HeronMkII/pay-pcbs/README.md

# Payload Subsystem PCBs

Currently includes:  

* pay-ssm v2
* pay-led v1
* pay-sensor v1

Schematic & PCB layout files for each respective board.

Layout done in KiCad.
