HeronMkII/pay-pcbs/pay-led/_outputs/pay-led-pcb.pdf

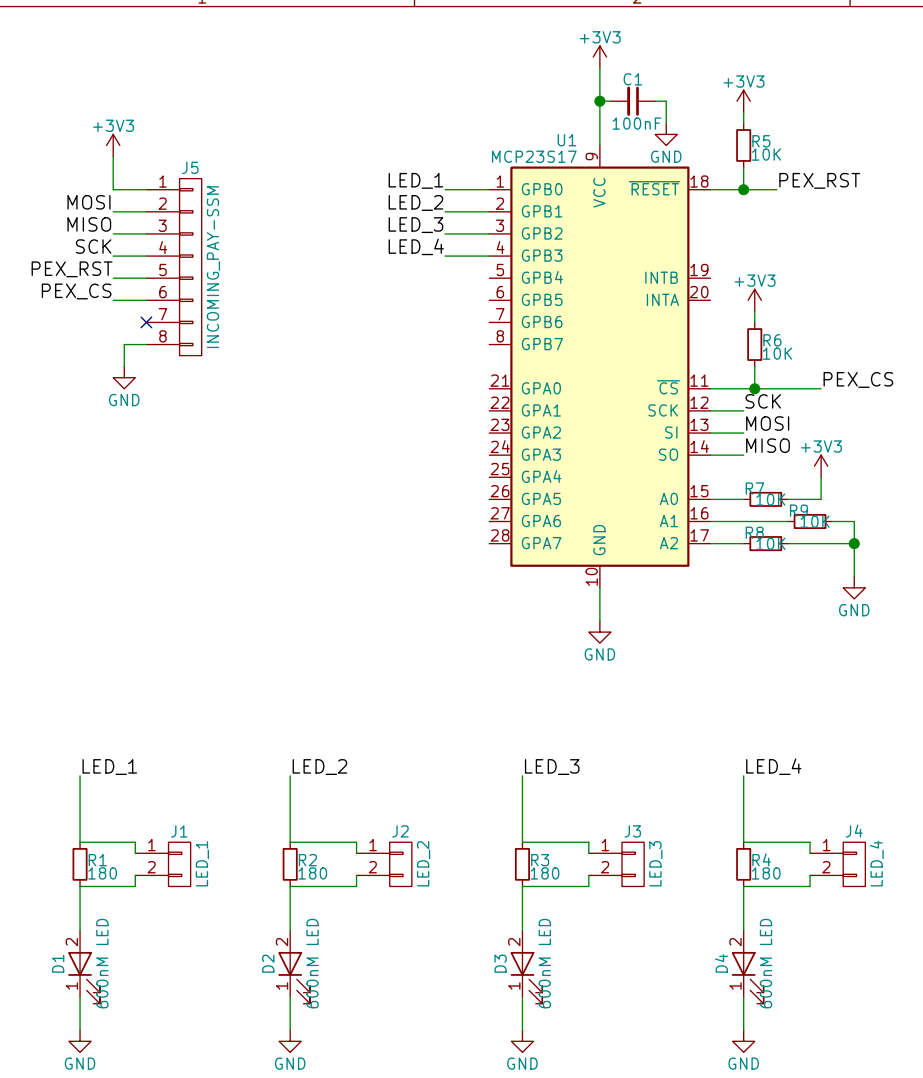
[picture p1: page 1]

File: pay-led-pcb.sch Sheet: /
