HeronMkII/pay-pcbs/pay-sensor/_outputs/pay_sensors.pdf

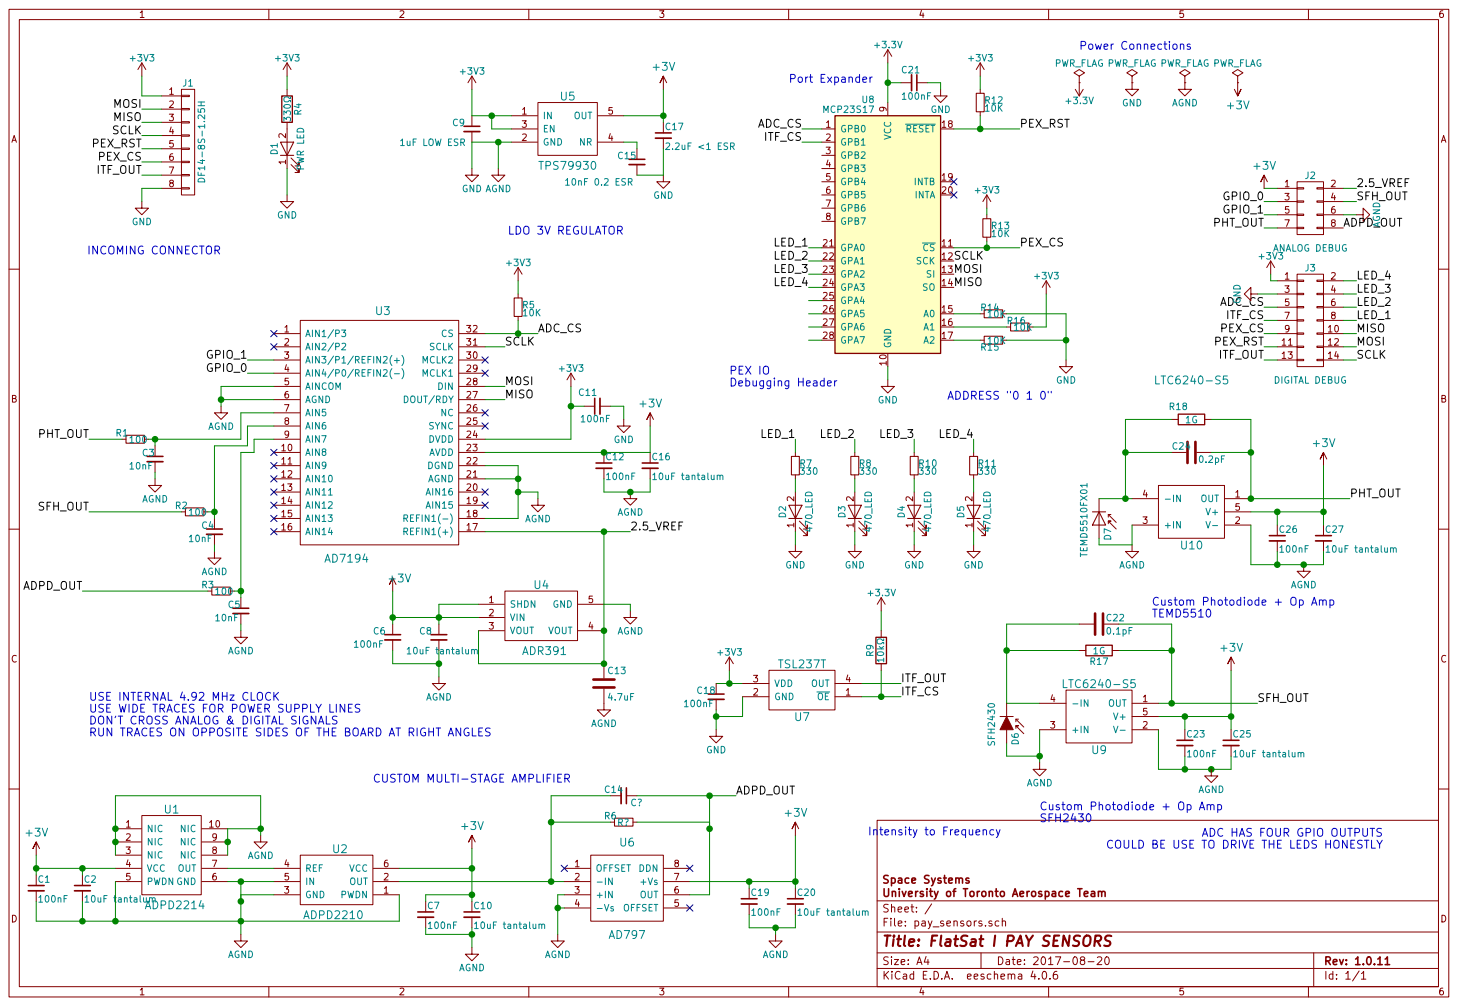
[picture p2: page 1]

11 | 12
13 | 14

USE INTERNAL 4.92 MHz CLOCK
USE WIDE TRACES FOR POWER SUPPLY LINES
DON'T CROSS ANALOG & DIGITAL SIGNALS
RUN TRACES ON OPPOSITE SIDES OF THE BOARD AT RIGHT ANGLES

CUSTOM MULTI-STAGE AMPLIFIER

Custom Photodiode + Op Amp
SFH2430

ADC HAS FOUR GPIO OUTPUTS

COULD BE USE TO DRIVE THE LEDS HONESTLY

Id: 1/1 Title: FlatSat I PAY SENSORS
