HeronMkII/pay-pcbs/pay-ssm/_outputs/pay_ssm.pdf

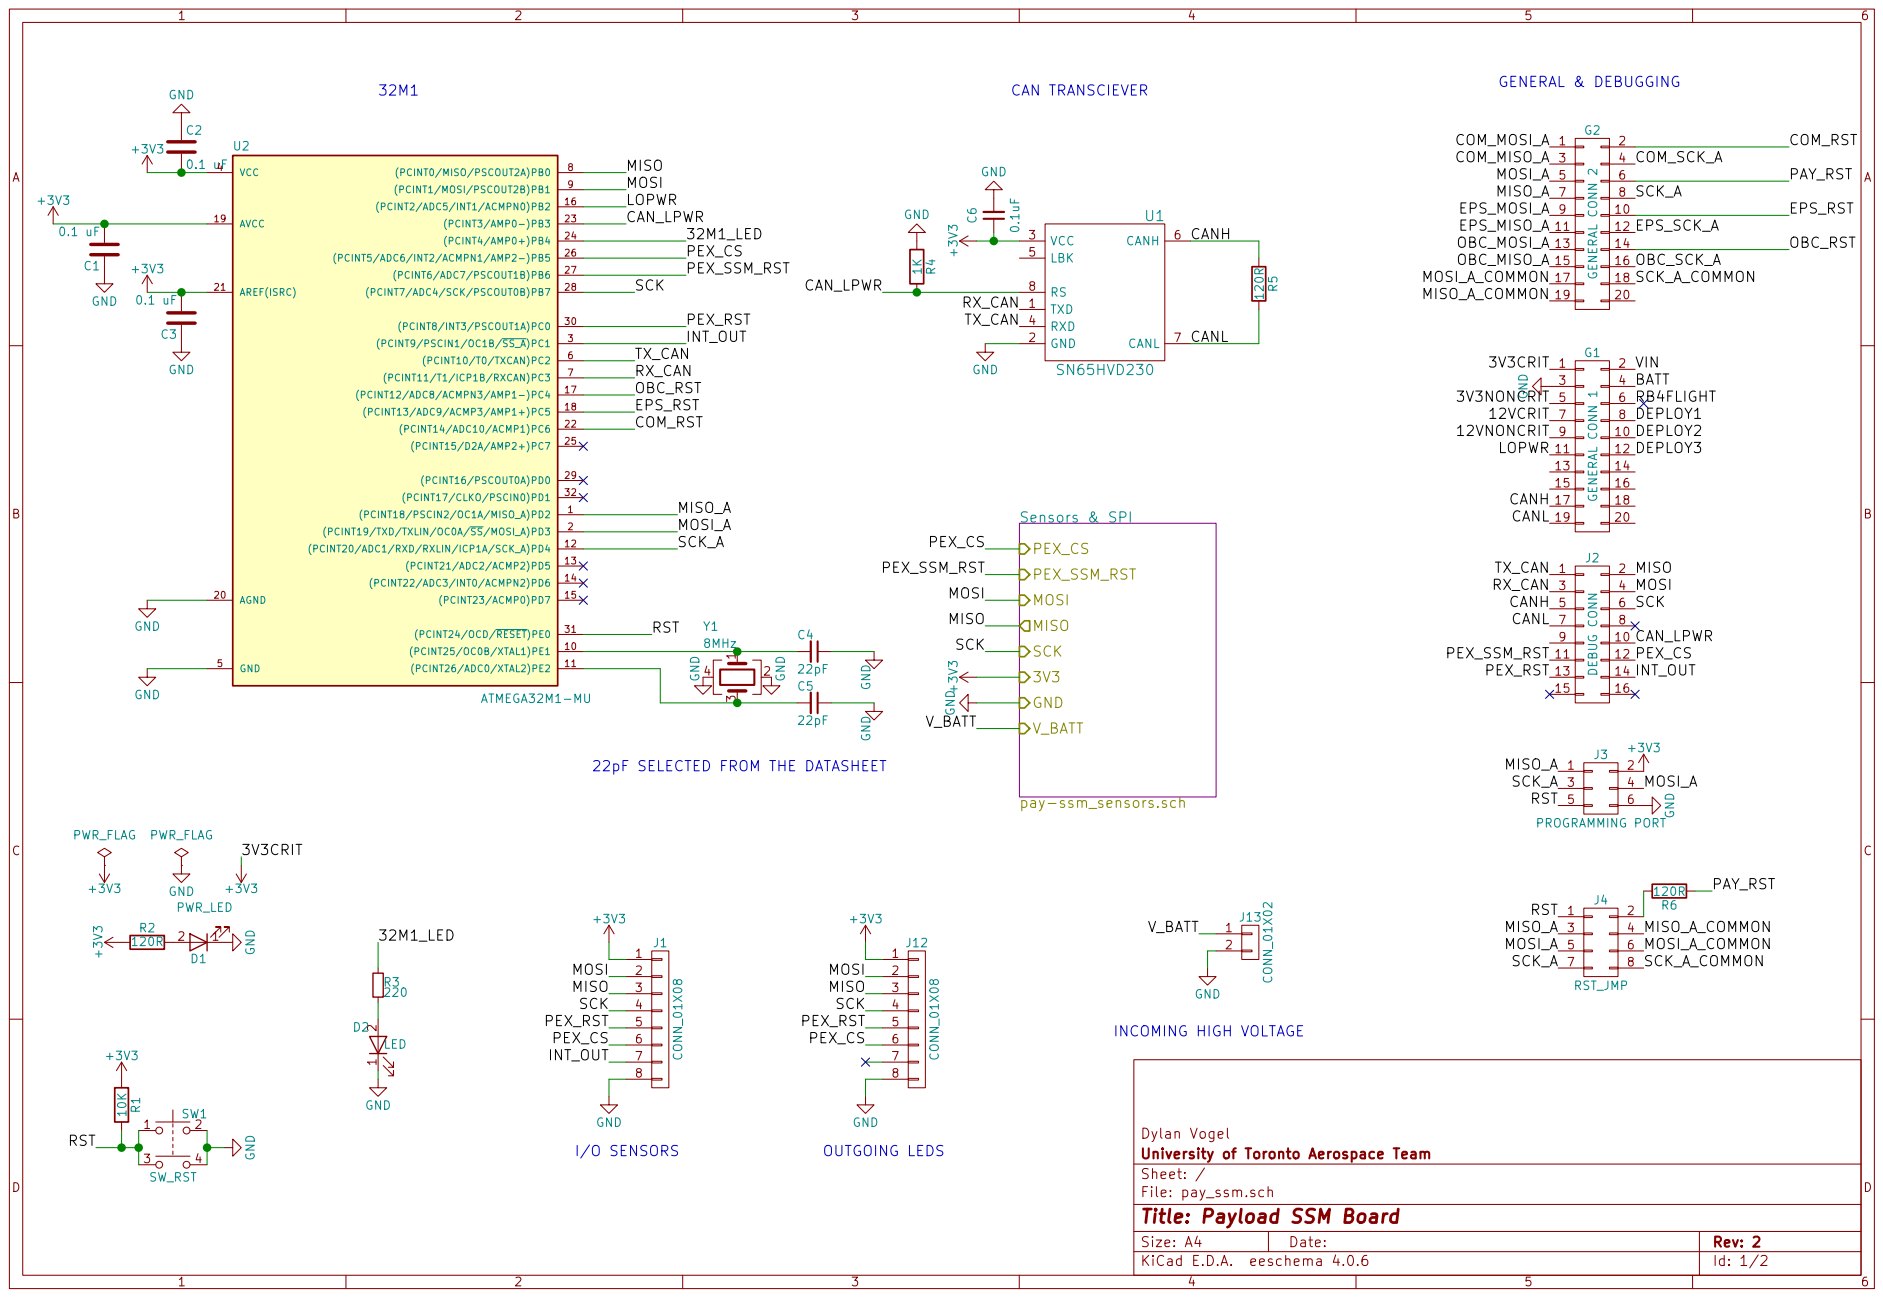
[picture p3: page 1]

9 | 10

11 | 12
13 | 14

22pF SELECTED FROM THE DATASHEET

File: pay_ssm.sch Sheet: / University of Toronto Aerospace Team

Id: 1/2 Title: Payload SSM Board

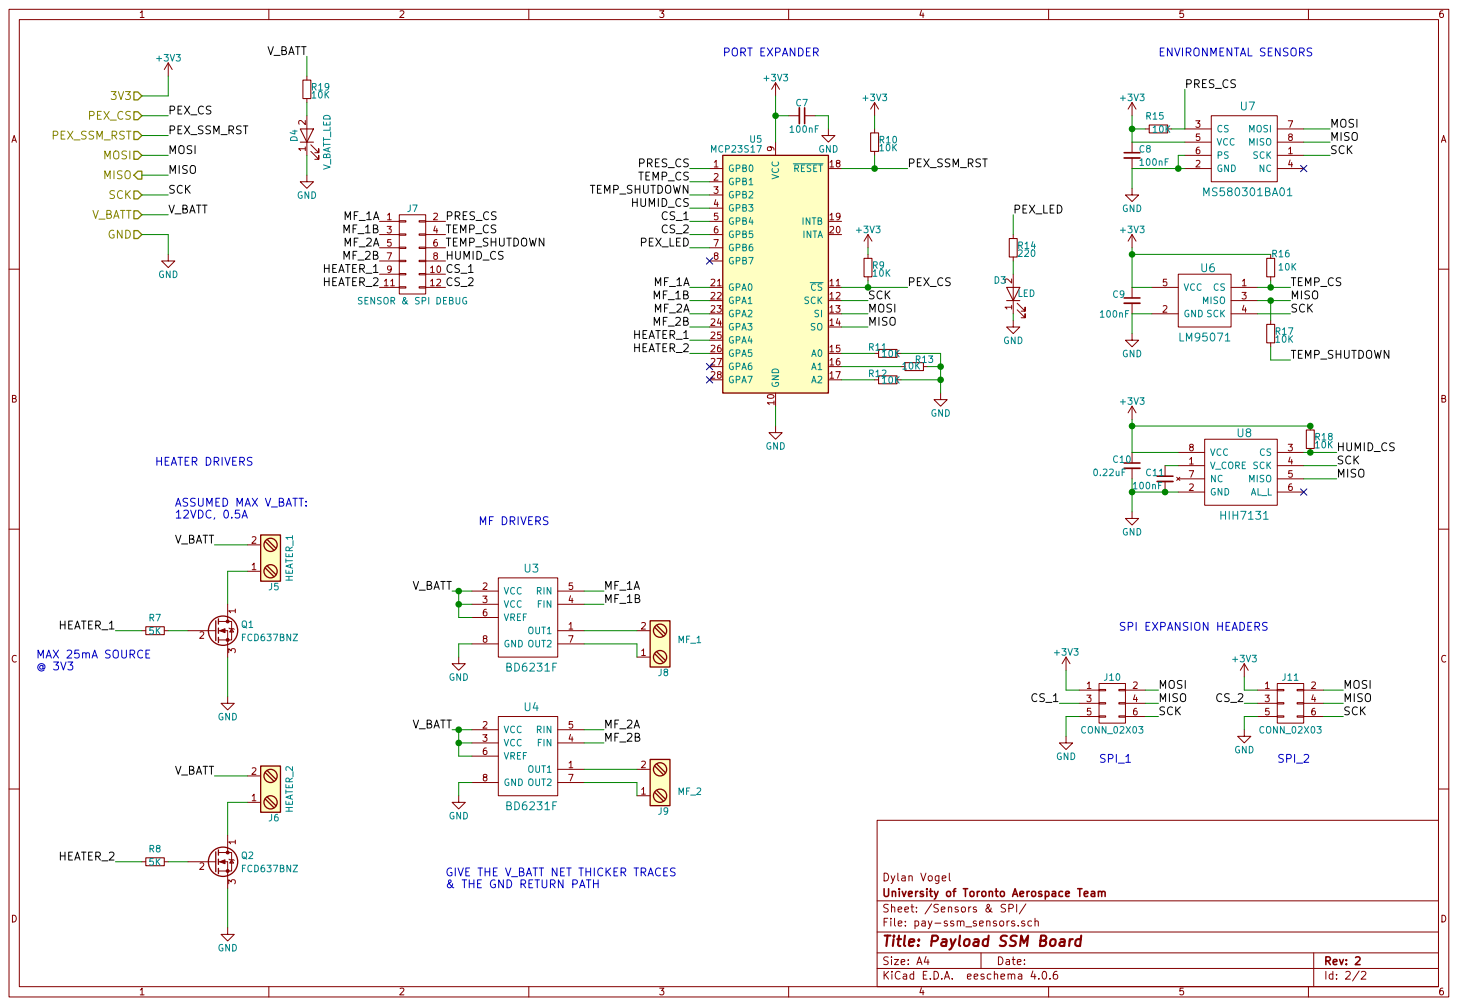
[picture p4: page 2]

Dylan Vogel
File: pay-ssm_sensors.sch Sheet: /Sensors & SPI/ University of Toronto Aerospace Team

& THE GND RETURN PATH

Id: 2/2 Title: Payload SSM Board
