HeronMkII/pay-pcbs/pay-sensor/pay_sensors.kicad_pcb

## KiCad design pay-sensor/pay_sensors.kicad_pcb (2017-09-02)

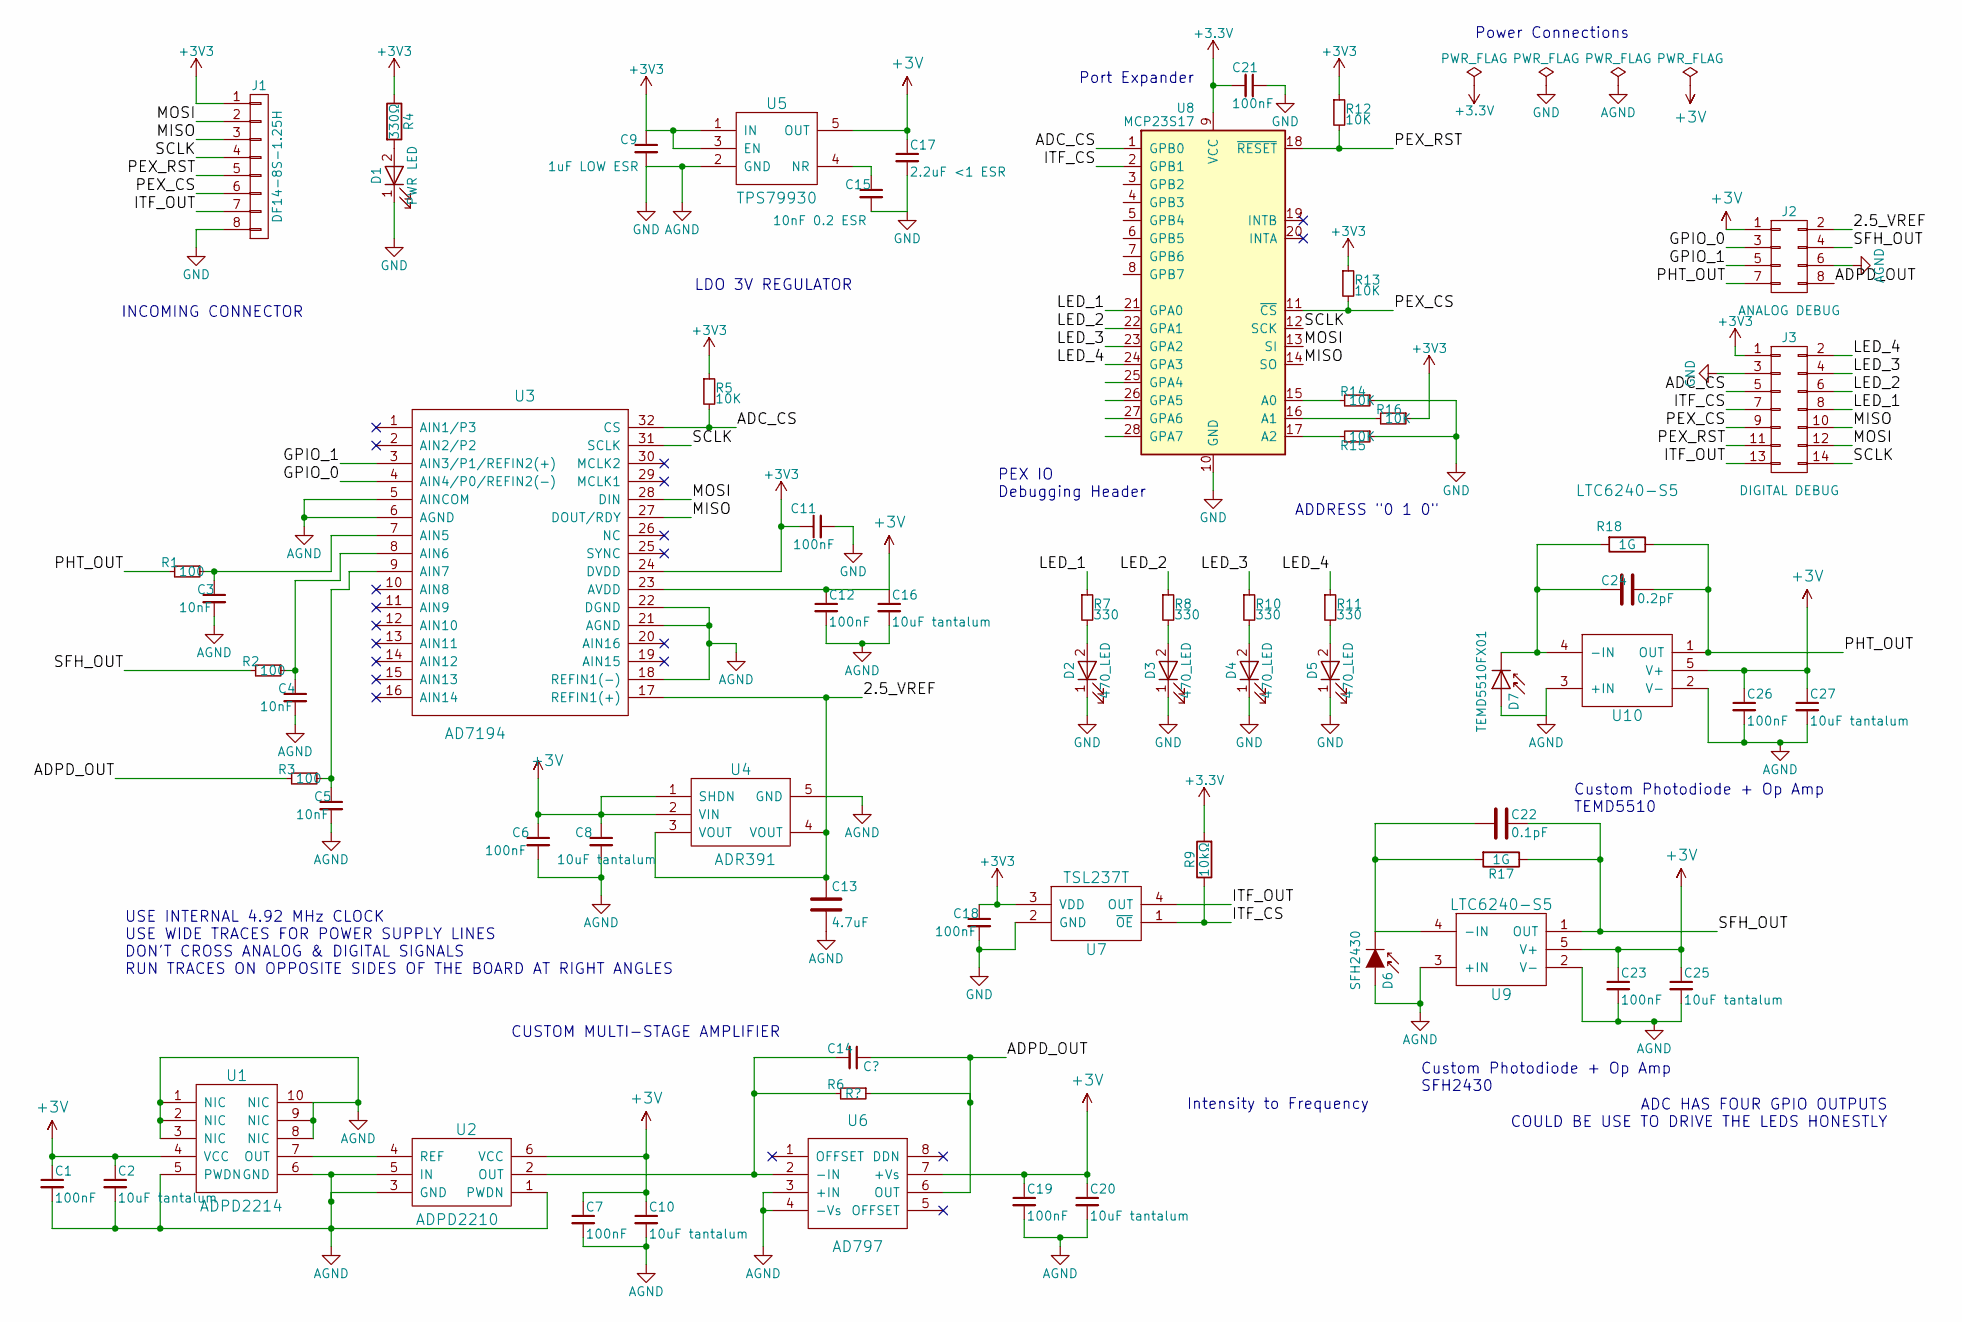
[picture p5: schematic pay_sensors.sch, FlatSat I PAY SENSORS]

Parts:
C1, C6, C7, C11, C12, C18, C19, C21, C23, C26: 100nF; C_0603
C2, C8, C10, C16, C20, C25, C27: 10uF tantalum; C_0603
C3, C4, C5: 10nF; C_0603
C9: 1uF LOW ESR; C_0603
C13: 4.7uF; C_0603
C14: C?; C_0603
C15: 10nF 0.2 ESR; C_0603
C17: 2.2uF <1 ESR; C_0603
C22: 0.1pF; C_0603
C24: 0.2pF; C_0603
D1: PWR LED; LED_0603
D2, D3, D4, D5: 470_LED; LED_0603
D6: SFH2430
D7: TEMD5510FX01; TEMD5510
J1: DF14-8S-1.25H; Hirose_DF14-8P-1.25H
J2: ANALOG DEBUG; Socket_Strip_Straight_2x04_Pitch2.54mm
J3: DIGITAL DEBUG; Socket_Strip_Straight_2x07_Pitch2.54mm
R1, R2, R3: 100; R_0603
R4: 330Ω; R_0603
R5, R12, R13, R14, R15, R16: 10K; R_0603
R6: R?; R_0603
R7, R8, R10, R11: 330; R_0603
R9: 10kΩ; R_0603
R17, R18: 1G; R_0603
U1: ADPD2214
U2: ADPD2210
U3: AD7194; QFN-32-1EP_5x5mm_Pitch0.5mm
U4: ADR391; SOT-23-5
U5: TPS79930; SOT-23-5
U6: AD797; SOIC-8_3.9x4.9mm_Pitch1.27mm
U7: TSL237T
U8: MCP23S17; SSOP-28_5.3x10.2mm_Pitch0.65mm
U9, U10: LTC6240-S5; SOT-23-5

Connections:
+3V: C1.1, C2.1, C6.1, C7.1, C8.1, C10.1, C12.1, C16.1, C17.1, C19.1, C20.1, C23.1, C25.1, C26.1, C27.1, J2.1, U1.4 (VCC), U2.6 (VCC), U3.23 (AVDD), U4.1 (SHDN), U4.2 (VIN), U5.5 (OUT), U6.7 (+Vs), U9.5 (V+), U10.5 (V+)
/2.5_VREF: C13.1, J2.2, U3.17 (REFIN1(+)), U4.3 (VOUT), U4.4 (VOUT)
/ADC_CS: J3.5, R5.2, U3.32 (CS), U8.1 (GPB0)
/ADPD_OUT: C14.1, J2.8, R3.2, R6.1, U6.6 (OUT)
/GPIO_0: J2.3, U3.4 (AIN4/P0/REFIN2(-))
/GPIO_1: J2.5, U3.3 (AIN3/P1/REFIN2(+))
/ITF_CS: J3.7, R9.1, U7.1 (~OE), U8.2 (GPB1)
/ITF_OUT: J1.7, J3.13, U7.4 (OUT)
/LED_1: J3.8, R7.1, U8.21 (GPA0)
/LED_2: J3.6, R8.1, U8.22 (GPA1)
/LED_3: J3.4, R10.1, U8.23 (GPA2)
/LED_4: J3.2, R11.1, U8.24 (GPA3)
/MISO: J1.3, J3.10, U3.27 (DOUT/RDY), U8.14 (SO)
/MOSI: J1.2, J3.12, U3.28 (DIN), U8.13 (SI)
/PEX_CS: J1.6, J3.9, R13.2, U8.11 (~CS)
/PEX_RST: J1.5, J3.11, R12.2, U8.18 (~RESET)
/PHT_OUT: C24.1, J2.7, R1.2, R18.1, U10.1 (OUT)
/SCLK: J1.4, J3.14, U3.31 (SCLK), U8.12 (SCK)
/SFH_OUT: C22.1, J2.4, R2.2, R17.1, U9.1 (OUT)
AGND: C1.2, C2.2, C3.2, C4.2, C5.2, C6.2, C7.2, C8.2, C9.2, C10.2, C11.2, C12.2, C13.2, C15.2, C16.2, C17.2, C18.2, C19.2, C20.2, C21.1, C23.2, C25.2, C26.2, C27.2, D1.1 (K), D2.1 (K), D3.1 (K), D4.1 (K), D5.1 (K), D6.2 (A), D7.2 (A), J1.8, J2.6, J3.3, R14.1, R15.1, U1.1 (NIC), U1.2 (NIC), U1.3 (NIC), U1.5 (PWDN), U1.6 (GND), U1.8 (NIC), U1.9 (NIC), U1.10 (NIC), U2.1 (PWDN), U2.3 (GND), U2.5 (IN), U3.5 (AINCOM), U3.6 (AGND), U3.18 (REFIN1(-)), U3.21 (AGND), U3.22 (DGND), U4.5 (GND), U5.2 (GND), U6.3 (+IN), U6.4 (-Vs), U7.2 (GND), U8.10 (GND), U9.2 (V-), U9.3 (+IN), U10.2 (V-), U10.3 (+IN)
unnamed: C3.1, R1.1, U3.7 (AIN5)
unnamed: C4.1, R2.1, U3.8 (AIN6)
unnamed: C5.1, R3.1, U3.9 (AIN7)
unnamed: C14.2, R6.2, U2.2 (OUT), U6.2 (-IN)
unnamed: C15.1, U5.4 (NR)
unnamed: C22.2, D6.1 (K), R17.2, U9.4 (-IN)
unnamed: C24.2, D7.1 (K), R18.2, U10.4 (-IN)
unnamed: D1.2 (A), R4.2
unnamed: D2.2 (A), R7.2
unnamed: D3.2 (A), R8.2
unnamed: D4.2 (A), R10.2
unnamed: D5.2 (A), R11.2
unnamed: R14.2, U8.15 (A0)
unnamed: R15.2, U8.17 (A2)
unnamed: R16.2, U8.16 (A1)
unnamed: U1.7 (OUT), U2.4 (REF)

Notes on the sheet:
Port Expander
Power Connections
Custom Photodiode + Op Amp TEMD5510
PEX IO Debugging Header
ADDRESS "0 1 0"
INCOMING CONNECTOR
LDO 3V REGULATOR
USE INTERNAL 4.92 MHz CLOCK USE WIDE TRACES FOR POWER SUPPLY LINES DON'T CROSS ANALOG & DIGITAL SIGNALS RUN TRACES ON OPPOSITE SIDES OF THE BOARD AT RIGHT ANGLES
CUSTOM MULTI-STAGE AMPLIFIER
ADC HAS FOUR GPIO OUTPUTS COULD BE USE TO DRIVE THE LEDS HONESTLY
Custom Photodiode + Op Amp SFH2430
Intensity to Frequency

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
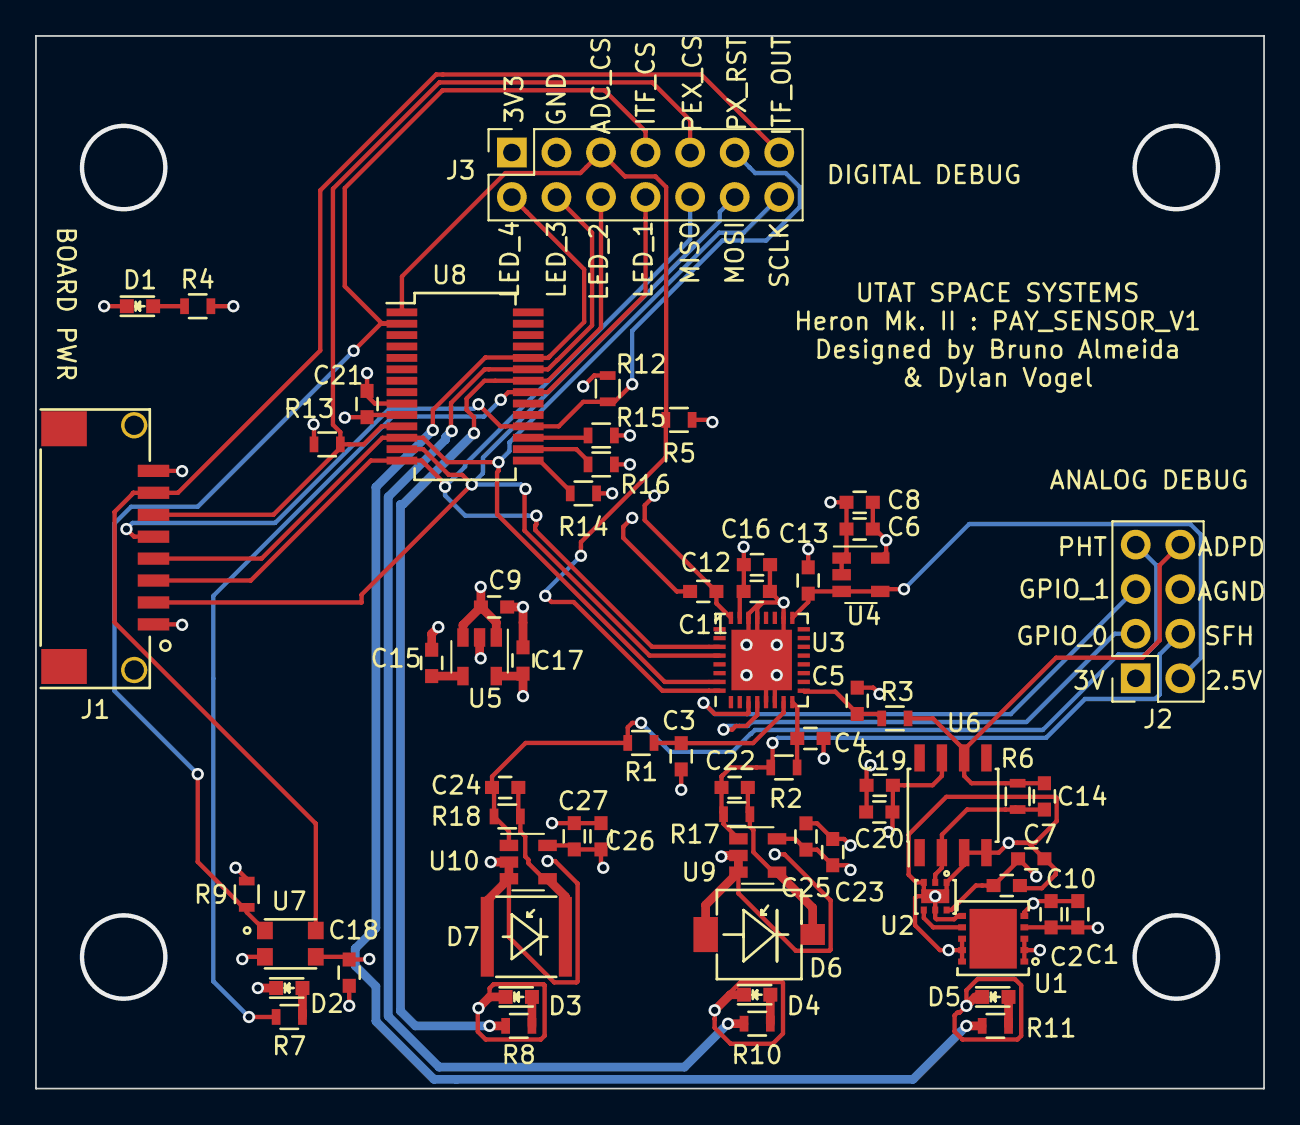
[picture p6: board pay_sensors.kicad_pcb from above]

Board: 4 copper layers, 70.0 x 60.0 mm, 65 parts (0 on the bottom side), 37 nets.
