HeronMkII/pay-pcbs/pay-ssm/pay_ssm.kicad_pcb

## KiCad design pay-ssm/pay_ssm.kicad_pcb (2017-09-02)

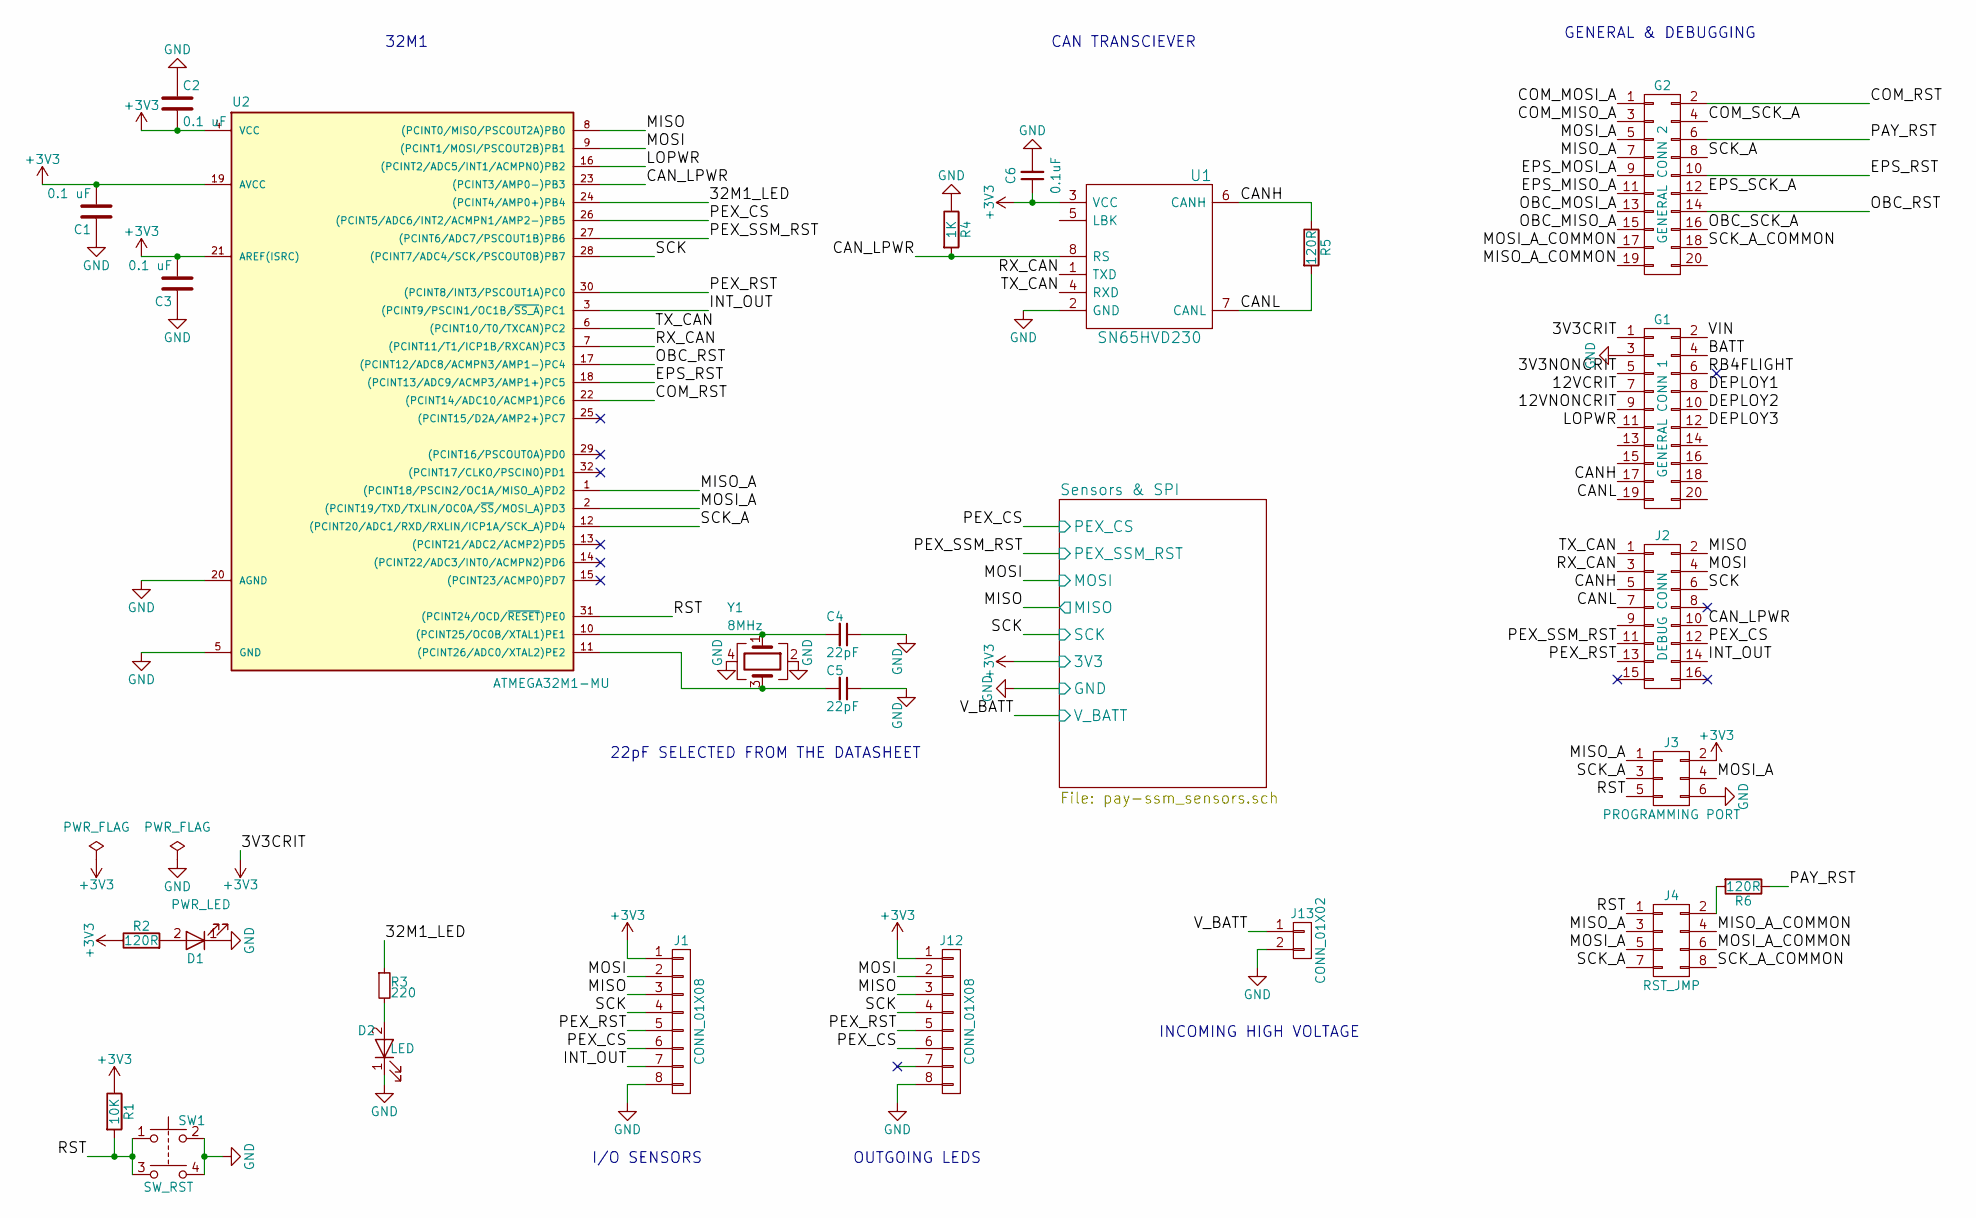
[picture p7: schematic pay_ssm.sch, Payload SSM Board]

Parts:
C1, C2, C3: 0.1 uF; C_0603
C4, C5: 22pF; C_0603
C6: 0.1uF; C_0603
D1: PWR_LED; LED_0603
D2: LED; LED_0603
G1: GENERAL CONN 1; Socket_Strip_Straight_2x10_Pitch2.54mm
G2: GENERAL CONN 2; Socket_Strip_Straight_2x10_Pitch2.54mm
J1, J12: CONN_01X08; Hirose_DF14-8P-1.25H
J2: DEBUG CONN; Socket_Strip_Straight_2x08_Pitch2.54mm
J3: PROGRAMMING PORT; IDC_Header_Straight_6pins
J4: RST_JMP; Socket_Strip_Straight_2x04_Pitch2.54mm
J13: CONN_01X02; Socket_Strip_Straight_1x02_Pitch2.54mm
R1: 10K; R_0603
R2, R5, R6: 120R; R_0603
R3: 220; R_0603
R4: 1K; R_0603
SW1: SW_RST; SW_SPST_B3S-1000
U1: SN65HVD230; SOIC-8_3.9x4.9mm_Pitch1.27mm
U2: ATMEGA32M1-MU; TQFP-32_7x7mm_Pitch0.8mm
Y1: 8MHz; Crystal_SMD_Abracon_ABM3B-4pin_5.0x3.2mm

Connections:
+3V3: C1.2, C2.2, C3.2, C6.1, G1.1, J1.1, J3.2, J12.1, R1.1, R2.1, U1.3 (VCC), U2.4 (VCC), U2.19 (AVCC), U2.21 (AREF(ISRC)); also elsewhere on the board
/3V3NONCRIT: G1.5
/12VCRIT: G1.7
/12VNONCRIT: G1.9
/32M1_LED: R3.1, U2.24 ((PCINT4/AMP0+)PB4)
/BATT: G1.4
/CANH: G1.17, J2.5, R5.1, U1.6 (CANH)
/CANL: G1.19, J2.7, R5.2, U1.7 (CANL)
/CAN_LPWR: J2.10, R4.2, U1.8 (RS), U2.23 ((PCINT3/AMP0-)PB3)
/COM_MISO_A: G2.3
/COM_MOSI_A: G2.1
/COM_RST: G2.2, U2.22 ((PCINT14/ADC10/ACMP1)PC6)
/COM_SCK_A: G2.4
/DEPLOY1: G1.8
/DEPLOY2: G1.10
/DEPLOY3: G1.12
/EPS_MISO_A: G2.11
/EPS_MOSI_A: G2.9
/EPS_RST: G2.10, U2.18 ((PCINT13/ADC9/ACMP3/AMP1+)PC5)
/EPS_SCK_A: G2.12
/INT_OUT: J1.7, J2.14, U2.3 ((PCINT9/PSCIN1/OC1B/~SS_A~)PC1)
/LOPWR: G1.11, U2.16 ((PCINT2/ADC5/INT1/ACMPN0)PB2)
/MISO: J1.3, J2.2, J12.3, U2.8 ((PCINT0/MISO/PSCOUT2A)PB0); also elsewhere on the board
/MISO_A: G2.7, J3.1, J4.3, U2.1 ((PCINT18/PSCIN2/OC1A/MISO_A)PD2)
/MISO_A_COMMON: G2.19, J4.4
/MOSI: J1.2, J2.4, J12.2, U2.9 ((PCINT1/MOSI/PSCOUT2B)PB1); also elsewhere on the board
/MOSI_A: G2.5, J3.4, J4.5, U2.2 ((PCINT19/TXD/TXLIN/OC0A/~SS~/MOSI_A)PD3)
/MOSI_A_COMMON: G2.17, J4.6
/OBC_MISO_A: G2.15
/OBC_MOSI_A: G2.13
/OBC_RST: G2.14, U2.17 ((PCINT12/ADC8/ACMPN3/AMP1-)PC4)
/OBC_SCK_A: G2.16
/PAY_RST: G2.6, R6.1
/PEX_CS: J1.6, J2.12, J12.6, U2.26 ((PCINT5/ADC6/INT2/ACMPN1/AMP2-)PB5); also elsewhere on the board
/PEX_RST: J1.5, J2.13, J12.5, U2.30 ((PCINT8/INT3/PSCOUT1A)PC0)
/PEX_SSM_RST: J2.11, U2.27 ((PCINT6/ADC7/PSCOUT1B)PB6); also elsewhere on the board
/RB4FLIGHT: G1.6
/RST: J3.5, J4.1, R1.2, SW1.1, SW1.3, U2.31 ((PCINT24/OCD/~RESET~)PE0)
/RX_CAN: J2.3, U1.1 (TXD), U2.7 ((PCINT11/T1/ICP1B/RXCAN)PC3)
/SCK: J1.4, J2.6, J12.4, U2.28 ((PCINT7/ADC4/SCK/PSCOUT0B)PB7); also elsewhere on the board
/SCK_A: G2.8, J3.3, J4.7, U2.12 ((PCINT20/ADC1/RXD/RXLIN/ICP1A/SCK_A)PD4)
/SCK_A_COMMON: G2.18, J4.8
/TX_CAN: J2.1, U1.4 (RXD), U2.6 ((PCINT10/T0/TXCAN)PC2)
/VIN: G1.2
/V_BATT: J13.1; also elsewhere on the board
GND: C1.1, C2.1, C3.1, C4.1, C5.1, C6.2, D1.1 (K), D2.1 (K), G1.3, J1.8, J3.6, J12.8, J13.2, R4.1, SW1.2, SW1.4, U1.2 (GND), U2.5 (GND), U2.20 (AGND), Y1.2, Y1.4; also elsewhere on the board
unnamed: C4.2, U2.10 ((PCINT25/OC0B/XTAL1)PE1), Y1.1
unnamed: C5.2, U2.11 ((PCINT26/ADC0/XTAL2)PE2), Y1.3
unnamed: D1.2 (A), R2.2
unnamed: D2.2 (A), R3.2
unnamed: J4.2, R6.2

Notes on the sheet:
22pF SELECTED FROM THE DATASHEET
I/O SENSORS
GENERAL & DEBUGGING
32M1
CAN TRANSCIEVER
INCOMING HIGH VOLTAGE
OUTGOING LEDS

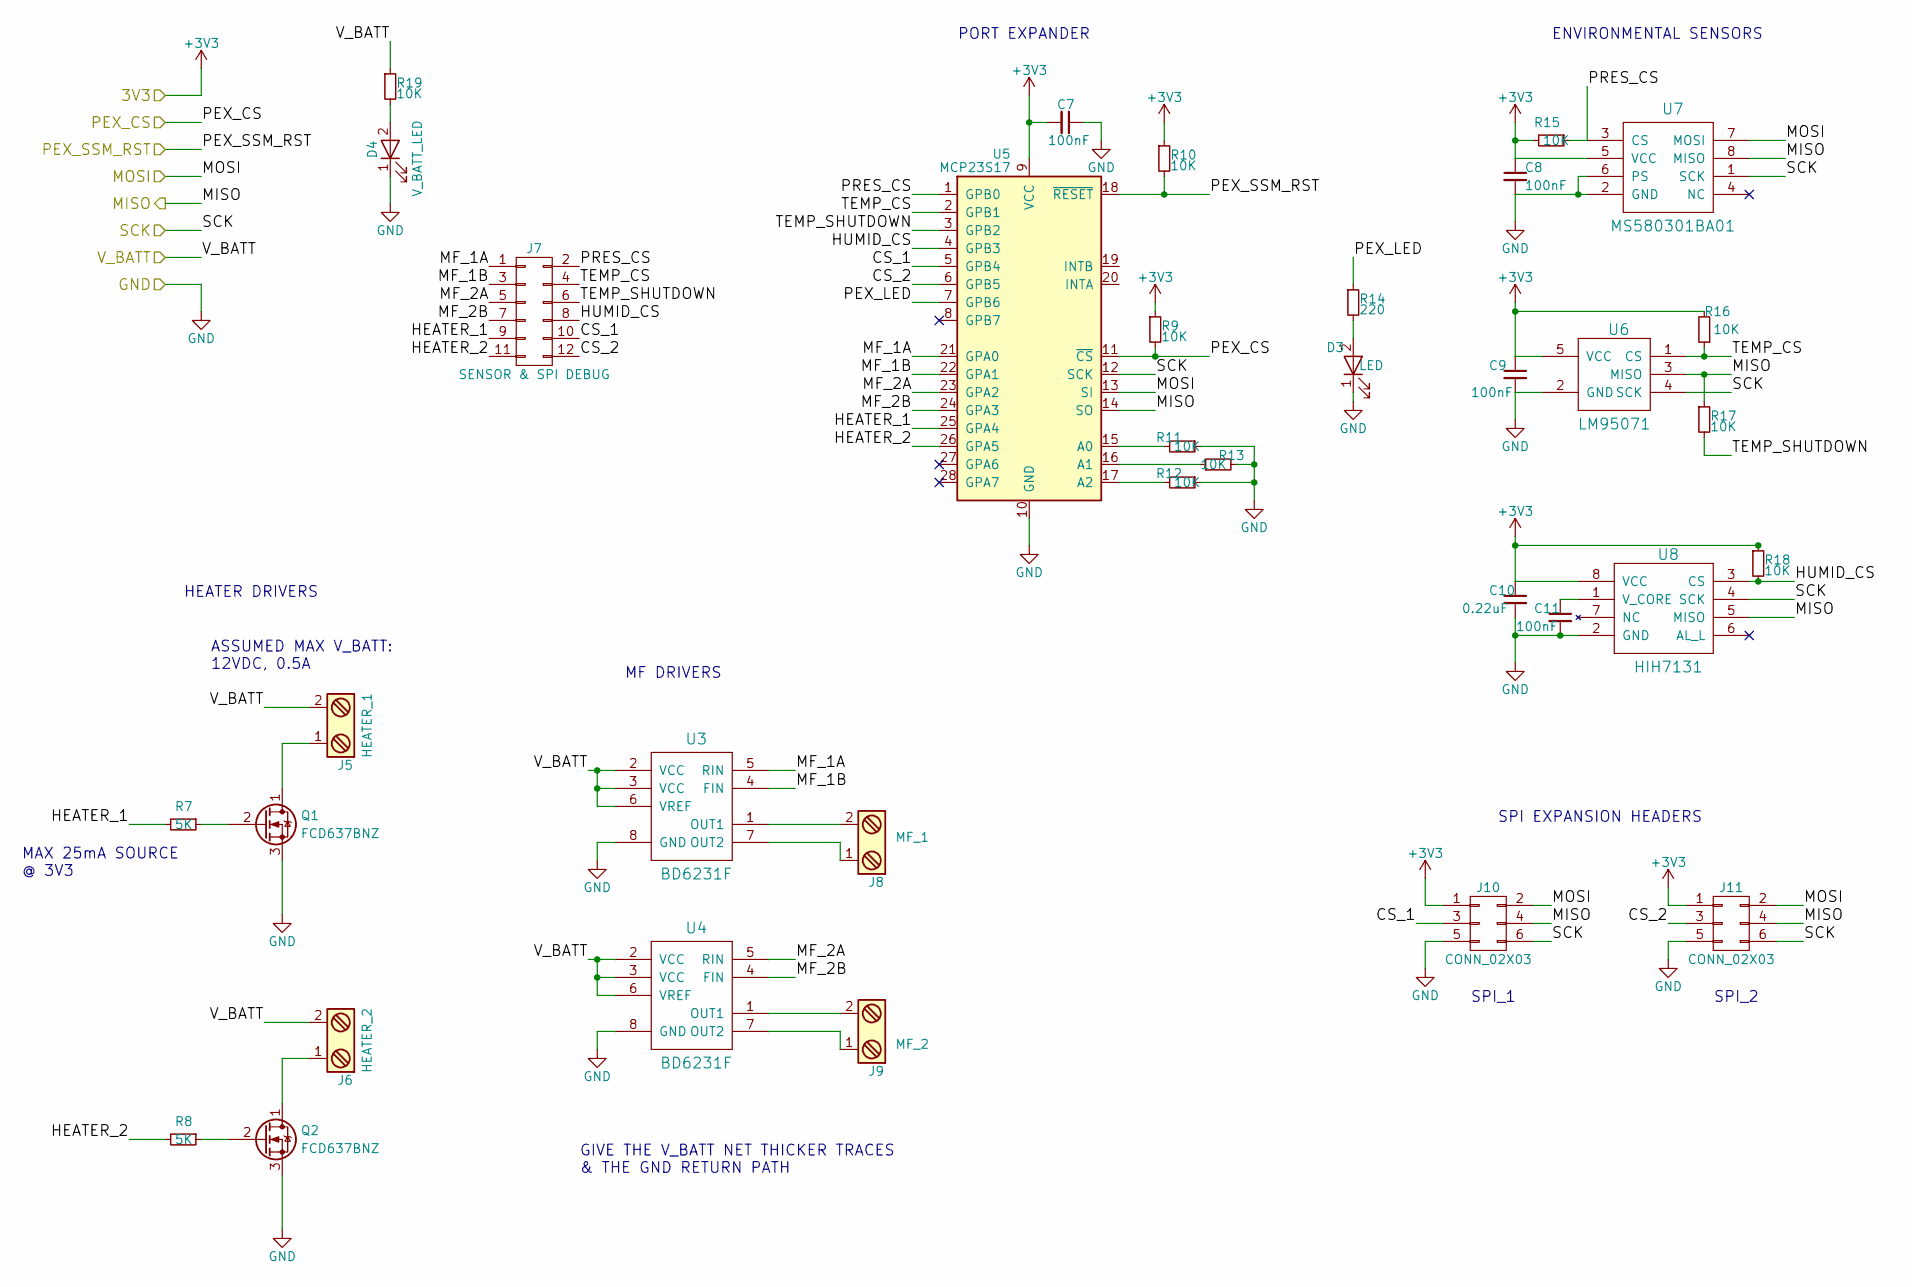
[picture p8: schematic pay-ssm_sensors.sch, Payload SSM Board]

Parts:
C7, C8, C9, C11: 100nF; C_0603
C10: 0.22uF; C_0603
D3: LED; LED_0603
D4: V_BATT_LED; LED_0603
J5: HEATER_1; TerminalBlock_Pheonix_MPT-2.54mm_2pol
J6: HEATER_2; TerminalBlock_Pheonix_MPT-2.54mm_2pol
J7: SENSOR & SPI DEBUG; Socket_Strip_Straight_2x06_Pitch2.54mm
J8: MF_1; TerminalBlock_Pheonix_MPT-2.54mm_2pol
J9: MF_2; TerminalBlock_Pheonix_MPT-2.54mm_2pol
J10, J11: CONN_02X03; Socket_Strip_Straight_2x03_Pitch2.54mm
Q1, Q2: FCD637BNZ; SOT-23-6
R7, R8: 5K; R_0603
R9, R10, R11, R12, R13, R15, R16, R17, R18, R19: 10K; R_0603
R14: 220; R_0603
U3, U4: BD6231F; SOIC-8_3.9x4.9mm_Pitch1.27mm
U5: MCP23S17; SSOP-28_5.3x10.2mm_Pitch0.65mm
U6: LM95071; SOT-23-5
U7: MS580301BA01; MS580301BA
U8: HIH7131; SOIC-8_3.9x4.9mm_Pitch1.27mm

Connections:
+3V3: C7.2, C8.1, C9.1, C10.1, J10.1, J11.1, R9.1, R10.1, R15.2, R16.2, R18.1, U5.9 (VCC), U6.5 (VCC), U7.5 (VCC), U8.8 (VCC); also elsewhere on the board
/MISO: J10.4, J11.4, R17.1, U5.14 (SO), U6.3 (MISO), U7.8 (MISO), U8.5 (MISO); also elsewhere on the board
/MOSI: J10.2, J11.2, U5.13 (SI), U7.7 (MOSI); also elsewhere on the board
/PEX_CS: R9.2, U5.11 (~CS); also elsewhere on the board
/PEX_SSM_RST: R10.2, U5.18 (~RESET); also elsewhere on the board
/SCK: J10.6, J11.6, U5.12 (SCK), U6.4 (SCK), U7.1 (SCK), U8.4 (SCK); also elsewhere on the board
/Sensors & SPI/CS_1: J7.10, J10.3, U5.5 (GPB4)
/Sensors & SPI/CS_2: J7.12, J11.3, U5.6 (GPB5)
/Sensors & SPI/HEATER_1: J7.9, R7.2, U5.25 (GPA4)
/Sensors & SPI/HEATER_2: J7.11, R8.2, U5.26 (GPA5)
/Sensors & SPI/HUMID_CS: J7.8, R18.2, U5.4 (GPB3), U8.3 (CS)
/Sensors & SPI/MF_1A: J7.1, U3.5 (RIN), U5.21 (GPA0)
/Sensors & SPI/MF_1B: J7.3, U3.4 (FIN), U5.22 (GPA1)
/Sensors & SPI/MF_2A: J7.5, U4.5 (RIN), U5.23 (GPA2)
/Sensors & SPI/MF_2B: J7.7, U4.4 (FIN), U5.24 (GPA3)
/Sensors & SPI/PEX_LED: R14.1, U5.7 (GPB6)
/Sensors & SPI/PRES_CS: J7.2, R15.1, U5.1 (GPB0), U7.3 (CS)
/Sensors & SPI/TEMP_CS: J7.4, R16.1, U5.2 (GPB1), U6.1 (CS)
/Sensors & SPI/TEMP_SHUTDOWN: J7.6, R17.2, U5.3 (GPB2)
/V_BATT: J5.2, J6.2, R19.1, U3.2 (VCC), U3.3 (VCC), U3.6 (VREF), U4.2 (VCC), U4.3 (VCC), U4.6 (VREF); also elsewhere on the board
GND: C7.1, C8.2, C9.2, C10.2, C11.2, D3.1 (K), D4.1 (K), J10.5, J11.5, Q1.3 (S), Q2.3 (S), R11.1, R12.1, R13.2, U3.8 (GND), U4.8 (GND), U5.10 (GND), U6.2 (GND), U7.2 (GND), U7.6 (PS), U8.2 (GND); also elsewhere on the board
unnamed: C11.1, U8.1 (V_CORE)
unnamed: D3.2 (A), R14.2
unnamed: D4.2 (A), R19.2
unnamed: J5.1, Q1.1 (D)
unnamed: J6.1, Q2.1 (D)
unnamed: J8.1, U3.7 (OUT2)
unnamed: J8.2, U3.1 (OUT1)
unnamed: J9.1, U4.7 (OUT2)
unnamed: J9.2, U4.1 (OUT1)
unnamed: Q1.2 (G), R7.1
unnamed: Q2.2 (G), R8.1
unnamed: R11.2, U5.15 (A0)
unnamed: R12.2, U5.17 (A2)
unnamed: R13.1, U5.16 (A1)

Notes on the sheet:
SPI_1
SPI_2
ENVIRONMENTAL SENSORS
PORT EXPANDER
SPI EXPANSION HEADERS
HEATER DRIVERS
MF DRIVERS
GIVE THE V_BATT NET THICKER TRACES & THE GND RETURN PATH
MAX 25mA SOURCE @ 3V3
ASSUMED MAX V_BATT: 12VDC, 0.5A

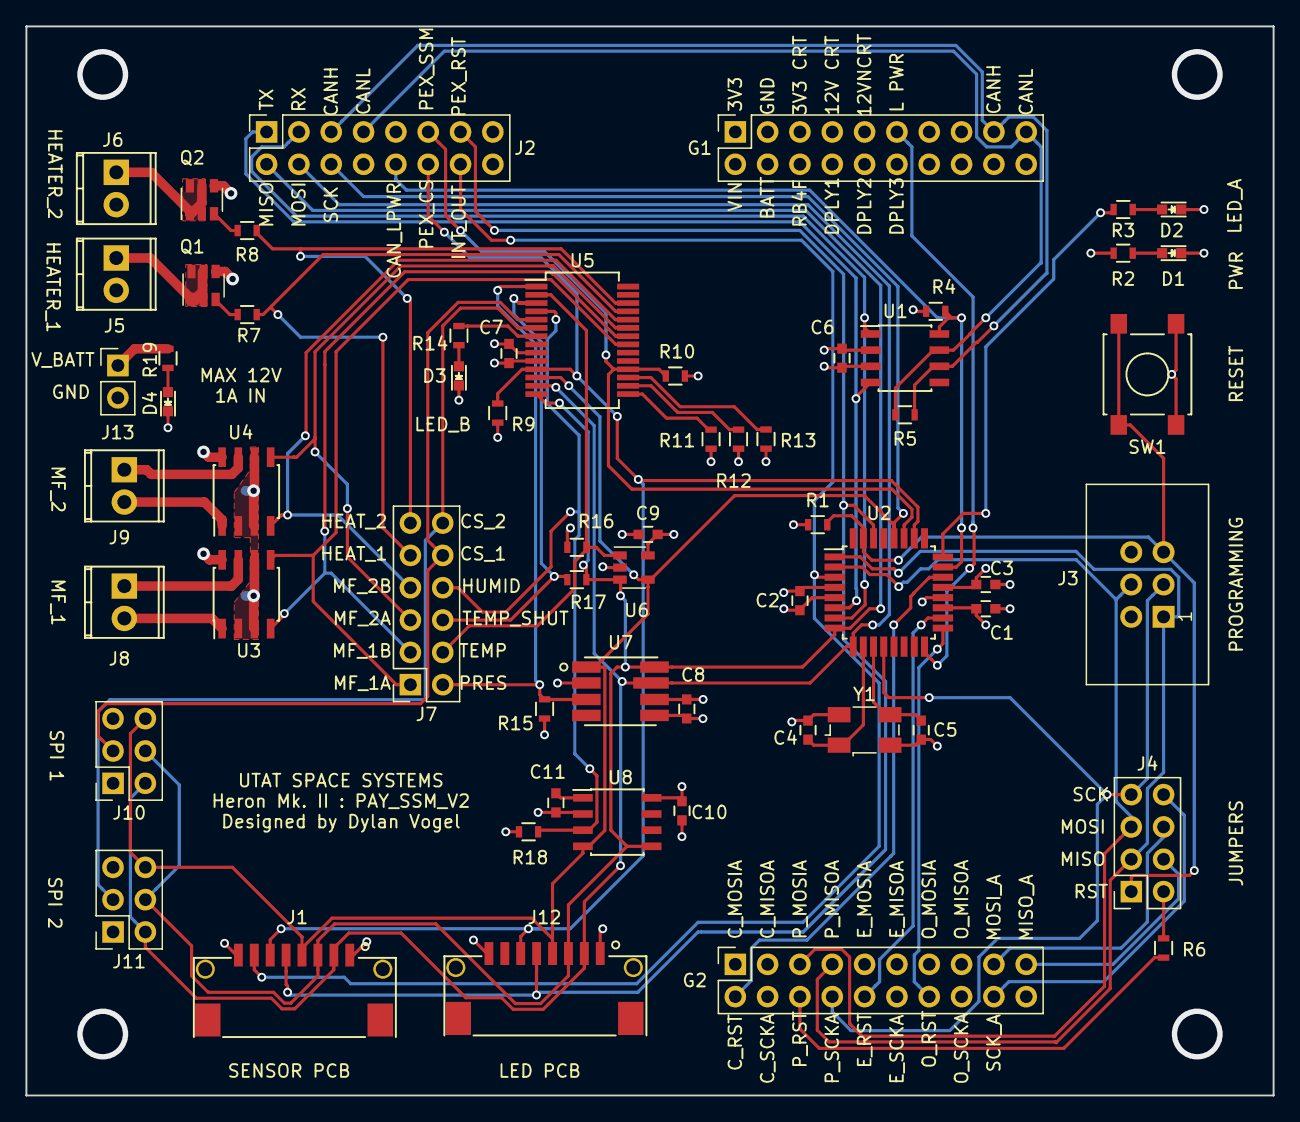
[picture p9: board pay_ssm.kicad_pcb from above]

Board: 4 copper layers, 98.0 x 84.0 mm, 61 parts (0 on the bottom side), 60 nets.
