HeronMkII/pay-pcbs/pay-led/pay-led-pcb.kicad_pcb

## KiCad design pay-led/pay-led-pcb.kicad_pcb (2017-09-02)

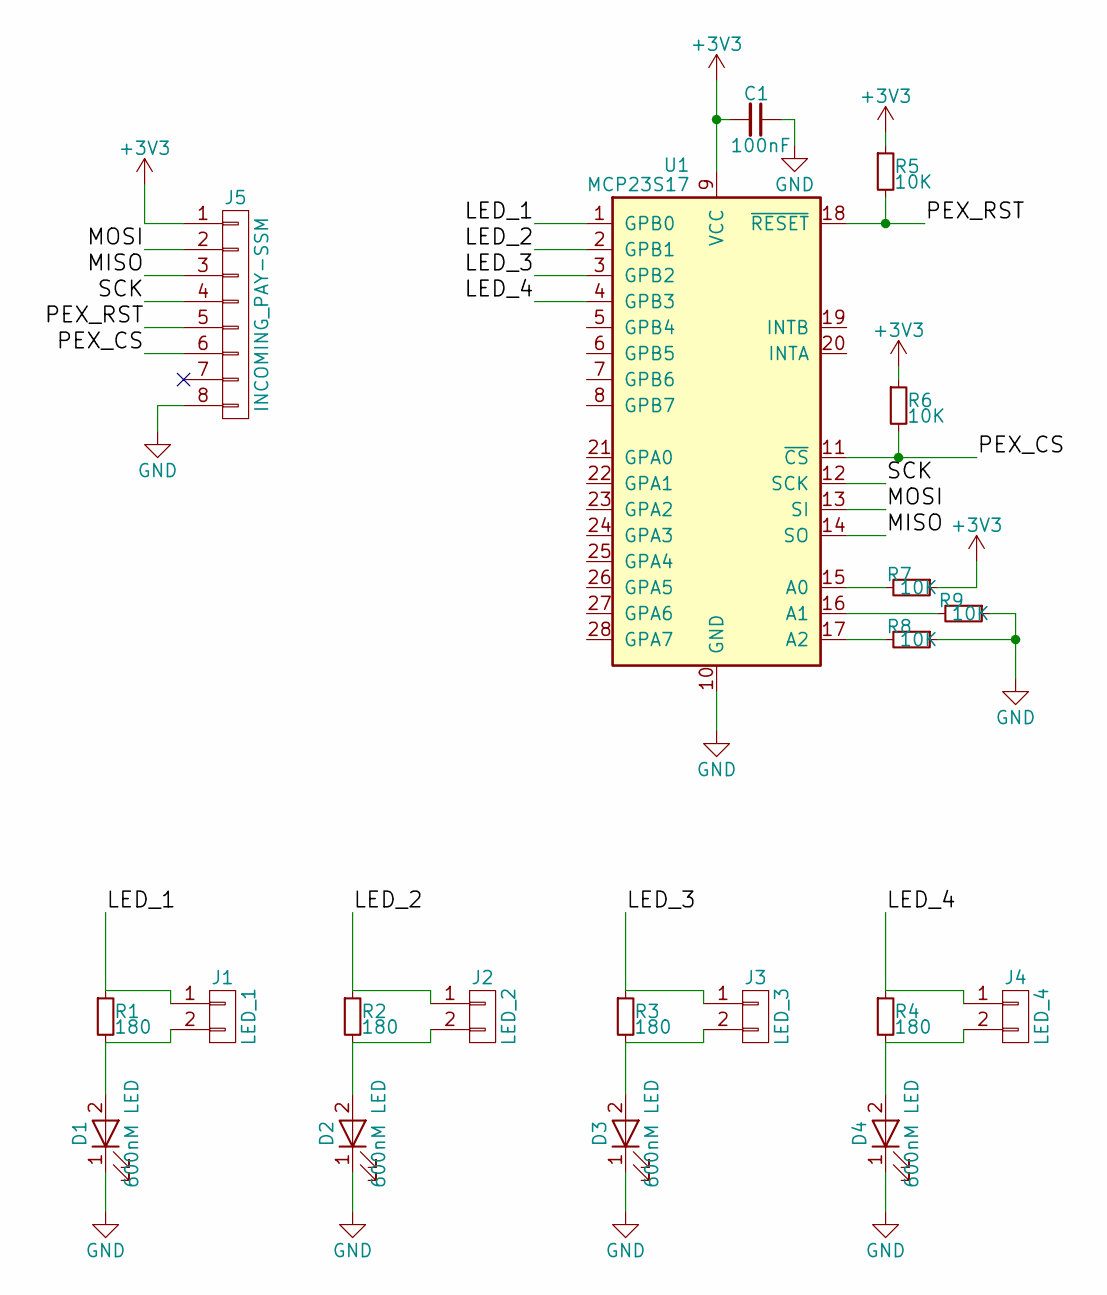
[picture p10: schematic pay-led-pcb.sch]

Parts:
C1: 100nF; C_0603
D1, D2, D3, D4: 600nM LED; LED_0603
J1: LED_1; Socket_Strip_Straight_1x02_Pitch2.54mm
J2: LED_2; Socket_Strip_Straight_1x02_Pitch2.54mm
J3: LED_3; Socket_Strip_Straight_1x02_Pitch2.54mm
J4: LED_4; Socket_Strip_Straight_1x02_Pitch2.54mm
J5: INCOMING_PAY-SSM; Hirose_DF14-8P-1.25H
R1, R2, R3, R4: 180; R_0603
R5, R6, R7, R8, R9: 10K; R_0603
U1: MCP23S17; SSOP-28_5.3x10.2mm_Pitch0.65mm

Connections:
+3V3: C1.2, J5.1, R5.1, R6.1, R7.1, U1.9 (VCC)
/LED_1: J1.1, R1.1, U1.1 (GPB0)
/LED_2: J2.1, R2.1, U1.2 (GPB1)
/LED_3: J3.1, R3.1, U1.3 (GPB2)
/LED_4: J4.1, R4.1, U1.4 (GPB3)
/MISO: J5.3, U1.14 (SO)
/MOSI: J5.2, U1.13 (SI)
/PEX_CS: J5.6, R6.2, U1.11 (~CS)
/PEX_RST: J5.5, R5.2, U1.18 (~RESET)
/SCK: J5.4, U1.12 (SCK)
GND: C1.1, D1.1 (K), D2.1 (K), D3.1 (K), D4.1 (K), J5.8, R8.1, R9.1, U1.10 (GND)
unnamed: D1.2 (A), J1.2, R1.2
unnamed: D2.2 (A), J2.2, R2.2
unnamed: D3.2 (A), J3.2, R3.2
unnamed: D4.2 (A), J4.2, R4.2
unnamed: R7.2, U1.15 (A0)
unnamed: R8.2, U1.17 (A2)
unnamed: R9.2, U1.16 (A1)

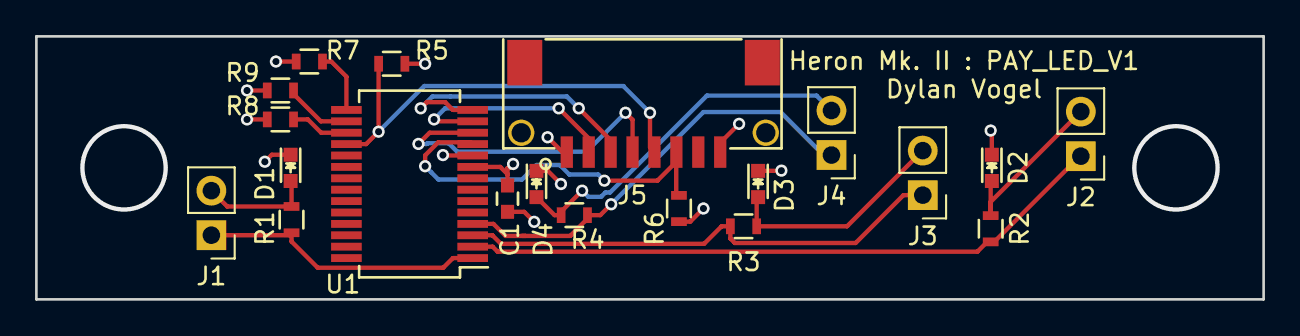
[picture p11: board pay-led-pcb.kicad_pcb from above]

Board: 4 copper layers, 70.0 x 15.0 mm, 20 parts (0 on the bottom side), 18 nets.
