HeronMkII/pay-pcbs/(commit log)

2017-08-20 Adding existing files
    [_saved_pay-ssm_sensors.sch, pay-ssm_sensors.sch, pay_ssm.kicad_pcb, pay_ssm.sch]
2017-08-20 Reverting README.md
    [_saved_pay-ssm_sensors.sch, pay-ssm_sensors.sch]
2017-08-21 Finished the PAY SSM PCB layout.
    [pay-ssm_sensors.sch, pay_ssm.kicad_pcb, pay_ssm.sch]
2017-08-21 Edited silkscreen.
    [pay_ssm.kicad_pcb]
2017-08-21 Added gerber outputs.
    [pay-ssm_sensors.sch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]
2017-09-02 Merging the 3 PAY boards into one repository.
    [pay-led-pcb-B.Cu.gbl, pay-led-pcb-B.Mask.gbs, pay-led-pcb-B.SilkS.gbo, pay-led-pcb-Edge.Cuts.gm1, pay-led-pcb-F.Cu.gtl, pay-led-pcb-F.Mask.gts, pay-led-pcb-F.Paste.gtp, pay-led-pcb-F.SilkS.gto]
2018-02-12 Update before Iteration3 Design - Added BOMs for previous iterotions
    [pay-led-pcb.csv, pay_sensors.csv, pay_sensors_1.csv, pay_ssm.csv]
